HandelNatividade/DCMotorControl-By-Acceleration/Controle_Digital.pdf

SEL0359 - Controle Digital - 2°sem/2025 Prof. Marcos Rogerio Fernandes ´

## Relatorio do Projeto Final ´

Handel Emanuel Natividade Peres - N°12681368 Pedro Augusto dos Santos Kzan - N°12547465

Resumo—O objetivo desta pratica se baseia na aplica ´ | çaõ
do seu proprio controle digital, por meio da modelagem do ´
sistema e discretizaçao do modelo. Foi necess ˜ | ario definir ´
criterios de desempenho, estruturar o controlador, realizar a ´ sua sintonia e implementa-lo. Posteriormente, se mostraram ´ os resultados para os distintos setpoints e a sua rejeiçao de ˜ ruído. O tema escolhido foi o controle de um Motor DC,
por meio de um acelerometro, com h ˆ | elices desbanlanceadas ´
para garantir vibraçao suficiente no aceler ˜ | ometro. ˆ
Por meio desta vibraçao medida, buscaram-se maneiras ˜
de associa-las ao n ´ | umero de Rota ´ | çoes por Minuto do motor ˜
(RPM).
Para isso, fez-se a modelagem do sistema por PRBS, discretizou-se por meio do metodo Segurador de Ordem Zero ´ (ZOH), implementou-se um controlador tipo PI sintonizado pelo PIDTuner e o rltool¹
| | e, tambem, uma sintonia fina. ´
Por fim, dadas as limitaçoes do controle PI e a ca- ˜
racterística nao linear do modelo, um controle de n ˜ | íveis
de velocidade (baixa, media e m ´ | axima) foi realizado com ´
sucesso, apesar do elevado ruído do sistema.
I. INTRODUÇ AÕ
O sistema utilizado na pratica ´ | e composto por um ´ | air
cooler, que e usada como um motor DC girante. Junto ´ a este motor, foi acoplado um sensor acelerometro. O ˆ
objetivo desta pratica ´ | e controlar a rota ´ | çao do ˜ | air cooler
por meio da sua vibraçao, capturada pelo aceler ˜ | ometro, ˆ
presente em 1.
Para isso, mapeamos o RPM por sua vibraçao corres- ˜ pondente por meio da calibraçao e, a partir disto, com a ˜ variavel ajustada (RPM estimado) realizar controle sobre ´ a velocidade do motor a partir deste RPM estimado, que
e funç ´ | ao da vibraç ˜ | ao obtida. ˜
A captura da vibraçao de um motor ˜ | e uma maneira ´
para mensurar a vida util dele: um motor que começa a ´ vibrar de forma anormal apresenta sinais que precisa de conserto ou substituiçao, ou que seu rendimento caiu ou ˜ esta prestes a se reduzir. ´
Ademais, para produzir um maior vibraçao do motor, ˜
adicionou-se pequenas deformaçoes nas h ˜ | elices do rotor ´
para que ele vibrasse mais ao girar.

1Ferramentas presentes no software Matlab v.R2023b

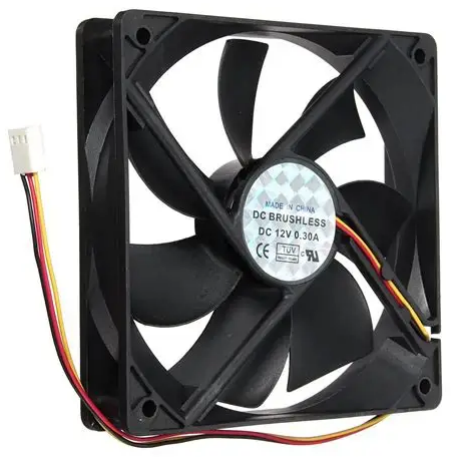
[picture p1: figure]

Figura 1: Figura ilutrativa da planta usada. Fonte: Aliexpress

A. Modelagens do Sistema
1) Modelagem de um Servomotor DC: Em geral,
o torque gerado por um motor CC e proporcional ´ | à
corrente de armadura e a intensidade do campo magn ` | etico. ´
Podemos assumir que o campo magnetico ´ | e constante e, ´
portanto, que o torque do motor e proporcional apenas ´ | à
corrente de armadura i por um fator constante Kt
, como
mostrado na equaçao abaixo. Este modelo ˜ | e conhecido ´
como motor controlado pela armadura.

T = Kt

i. (1)

A força contraeletromotriz (back emf), e, e proporcional ´
a velocidade angular do eixo por um fator constante ` | Ke.
e = Keθ˙. | (2)

Em unidades SI, as constantes de torque do motor e
da força contraeletromotriz sao iguais, isto ˜ | e,´ Kt = Ke.
Portanto, usaremos K para representar tanto a constante de torque quanto a constante de back emf.
Pode-se derivar as seguintes equaçoes governantes com ˜ base na 2ª lei de Newton e na lei das malhas de Kirchhoff. Kθ˙ representa uma voltagem gerada no motor, J o
momento de inercia do rotor, ´ | b coeficiente de atrito
viscoso.
Jθ¨ +bθ˙ = Ki. | (3)

L

di
dt
+Ri = V −Kθ˙. | (4)
FUNÇ AO DE ˜ | TRANSFERENCIA DA VELOCIDADE ˆ
ANGULAR DO MOTOR POR SUA TENSAO INDUZIDA NA ˜

ARMADURA
Aplicando a transformada de Laplace, as equaçoes de ˜ modelagem acima podem ser expressas em termos da
variavel de Laplace ´ | s.
s(Js+b)Θ(s) = K I(s). | (5)
(Ls+R)I(s) = V(s)−KsΘ(s). | (6)
Chegamos a seguinte fun ` | çao de transfer ˜ | encia em malha ˆ
aberta ao eliminar I(s) entre as duas equaçoes acima, ˜ considerando que a velocidade deve ser a saída e a tensaõ de armadura e a entrada. [3] ´

P(s) = Θ˙ (s)
V(s) = | K
s((Js+b)(Ls+R) +K²)
| | rad/s
| | V
| | ,
| | (7)
2) Modelagem do acelerometro ˆ | :
Modelagem da Funçao de Transfer ˜ | encia do Aceler ˆ | ometro ˆ
A modelagem dinamica de um aceler ˆ | ometro baseia-se ˆ
no princípio de um sistema massa–mola–amortecedor, no qual uma massa de prova e conectada ao corpo do sensor ´ por meio de uma mola de constante k e um amortecedor
de coeficiente c. A excitaçao externa ˜ | e o movimento ´
do corpo do sensor, denotado por u(t). O deslocamento relativo entre a massa de prova e o corpo e denotado por ´ x(t). [1]
A dinamica relativa entre ˆ | x(t) e u(t) e dada por: [1] ´
mx¨(t) +cx˙(t) +kx(t) = −mü(t). | (8)

Em que:
- m e a massa inercial do aceler ´ | ometro, ˆ
- c e o coeficiente de amortecimento, ´
- k e a rigidez da mola, ´
- u(t) e o movimento do corpo do sensor, ´
- x(t) e o deslocamento relativo da massa. ´ Aplicando a Transformada de Fourier e substituindo d/dt → jω, obtem-se: ´
X(ω) = | −ω
| 2

ω

2
0 −ω² + j(2ζω0ω)
U(ω), | (9)

em que ω0 =

p
k/m e a frequ ´ | encia natural e ˆ | ζ =
c/(2

√
km) e o fator de amortecimento. ´
Assim, a funçao de transfer ˜ | encia do sistema mec ˆ | anico ˆ
e:´

H(ω) = X(ω)
U(ω)
= | −ω

2

ω

| 2
0 −ω² + j(2ζω0ω)
. | (10)
Funçao de Transfer ˜ | encia no Caso de Baixas Frequ ˆ | encias ˆ
Para acelerometros MEMS, a frequ ˆ | encia natural ˆ | é
tipicamente muito elevada (ω0 ≫ faixa de operaçao), ˜ de modo que ω ≪ ω0. E mostrado por Hons e Stewart ´ (2006) que, nesse regime, a equaçao se simplifica para: ˜

H(ω) ≃

X(ω)
U(ω)

≃

1

ω

2
0
. | (11)

E como o transdutor converte diretamente o desloca-
mento relativo x(t) em tensao, a sa ˜ | ída e proporcional ´ | à
aceleraçao do corpo: ˜

x(t) ≈ −

1

ω

2
0
| | ü(t). | (12)

Assim, o acelerometro atua como um sensor de ˆ
aceleraçao com resposta plana na banda de operaç ˜ | | | ao. ˜
Expressao Normalizada da Funç ˜ | | ao de Transfer ˜ | encia ˆ

A forma mais utilizada em engenharia de controle para
documentar o acelerometro ˆ | e:´

H(s) = X(s)
U(s)
| = | s

2

s

2 +2ζω0s+ω

| | | 2
| | | 0
. | (13)
Esta funçao de transfer ˜ | encia descreve completamente ˆ
a dinamica mec ˆ | anica do aceler ˆ | ometro, representando um ˆ
sistema de segunda ordem típico de sensores MEMS.
3) Modelagem da Vibraçao da Ventoinha ˜ | : A ventoi-
nha utilizada no experimento funciona como um motor DC, produzindo vibraçao mec ˜ anica devido ao desbalance- ˆ amento do rotor. Essa vibraçao pode ser aproximada por ˜
um sinal harmonico, cuja frequ ˆ | encia depende diretamente ˆ
da velocidade angular do motor.
A aceleraçao medida pelo aceler ˜ | ometro pode ser ˆ
descrita por:
a(t) = Asin(ωt). | (14)

onde:
- A e a amplitude da vibraç ´ | ao; ˜
- ω e a velocidade angular do motor em rad/s. ´
A amplitude da vibraçao cresce proporcionalmente ˜ | à
velocidade angular:
| A ∝ ω; | | (15)

Portanto, o acelerometro pode ser utilizado como um ˆ estimador indireto da velocidade do motor, especialmente
atraves do c ´ | alculo do valor RMS da aceleraç ´ | ao medida. ˜
4) Relaçao entre Acelera ˜ | çao, Vibra ˜ | çao da Ventoinha ˜
e Potencia Mec ˆ | anica ˆ | : Com a modelagem do motor DC,
da vibraçao induzida pelo desbalanceamento do rotor ˜
e da dinamica do aceler ˆ | ometro, ˆ | e poss ´ | ível estabelecer
uma funçao de transfer ˜ | encia completa entre a pot ˆ | encia ˆ

mecanica produzida pelo motor e a acelera ˆ | | çao medida ˜
pelo sensor.
A vibraçao da ventoinha foi modelada como um ˜ sinal harmonico cuja amplitude depende diretamente da ˆ velocidade angular:
a(t) = Asin(ωt), | A ∝ ω. | (16)

Linearizando em torno de um ponto de operaçaõ ω0,
obtem-se a relaç ´ | ao de pequenos sinais: ˜
∆a(t) = Ka ∆ω(t), | (17)

onde Ka e um ganho determinado experimentalmente e ´ depende do nível de desbalanceamento da ventoinha.
Por outro lado, a potencia mec ˆ | anica do motor ˆ | e dada ´
por:
P(t) = T(t)ω(t) = Kt
| | i(t)ω(t). | (18)
Para pequenas variaçoes em torno do ponto ˜ | (i0,ω0), a
potencia pode ser linearizada: ˆ
∆P(t) ≃ Kt (i0 ∆ω(t) +ω0 ∆i(t)). | (19)

Assumindo que a corrente e regulada rapidamente ou ´
que suas variaçoes s ˜ | ao pequenas, ˜
| ∆P(t) ≈ Kt | i0 ∆ω(t). | (20)
Substituindo (17) em (20), obtem-se a rela ´ | çao est ˜ | atica ´
entre potencia e aceleraç ˆ | ao: ˜
| ∆P(t) = Kt

i0
Ka
| | ∆a(t). | (21)
a) Inclusao da Din ˜ | amica do Aceler ˆ | ometro: ˆ | A
dinamica do aceler ˆ | ometro foi previamente modelada como ˆ
um sistema massa–mola–amortecedor:
H(s) = X(s)
| U(s) = | s
| | 2

s

| | 2 +2ζω0s+ω
| | 2
| | 0
| | . | (22)
No regime de baixas frequencias (faixa de opera ˆ | çaõ
do experimento),
| x(t) ≈ −

1

ω

2
0
| | ü(t), | (23)
de modo que a saída do acelerometro ˆ | e diretamente ´
proporcional a aceleraç ` | ao verdadeira do corpo. ˜
Portanto, no domínio de Laplace, a aceleraçao medida ˜ e:´
A(s) = Hacc(s)U(s), | (24)

onde, no regime operacional,

Hacc(s) ≃ 1. | (25)
b) Funçao de Transfer ˜ | encia Final: Pot ˆ | encia a partir ˆ
da Aceleraçao: ˜ | Combinando (21) com a dinamica do ˆ
acelerometro, a fun ˆ | çao de transfer ˜ | encia entre a acelera ˆ | çaõ
medida e a potencia mec ˆ | anica ˆ | e:´

GP←A(s) = ∆P(s)
∆A(s)

=

Kt

i0
Ka

·

1

Hacc(s)

. | (26)
No regime de baixas frequencias — v ˆ | alido para ´
ventiladores de pequeno porte — tem-se Hacc(s) ≃ 1, e portanto:

GP←A(s) ≃

∆P(s)
∆A(s)

=

Kt

i0
Ka

(27)

Esta expressao mostra que a pot ˜ | encia mec ˆ | anica pode ˆ
ser estimada diretamente a partir da aceleraçao RMS ˜ medida pelo acelerometro, com um ganho proporcional ˆ que depende apenas das características do motor e sua corrente e do desbalanceamento das helices acopladas no ´ motor.
B. Controle no Sistema: PI

Para o controle neste trabalho, utilizamos controle PI.
O controle PI segue a formula ´ | 28:

u(t) = Kp e(t) +Ki

Z t

0

| e(τ)dτ | (28)

Deste modelo, temos que a parcela Kp, parcela proporcional, causa um efeito mais direto e agressivo no controle. Ela reduz o erro de forma proporcional a quanto erro ha no sistema. Aumentar esta parcela causa ´
resposta mais rapida e agressiva, mas um ´ | Kp alto demais
pode causar oscilaçoes e overshoot no sistema. Um valor ˜ baixo demais para Kp resulta em resposta mais distante do setpoint e mais lenta, muitas vezes com controle distante do setpoint ou fraco, insuficiente.
Ja a parcela ´ | Ki

, termo integrativo, soma o erro que já existe no sistema para realizar açao corretiva ao erro, ˜ eliminando o erro de regime permanente. Aumentar
esta parcela causa aproximaçao mais r ˜ | apida da sa ´ | ída
ao setpoint, porem com um valor alto demais, o ´ | | Ki
pode acumular para o erro valores maiores do que o verdadeiro, causando oscilaçoes em torno do setpoint, ou ˜ resposta errada frente a disturbios. Com um valor baixo ´ demais para Ki

, o sistema apresentara erro permanente ´ nao removido. ˜
Na sintonia do controlador PI, e necess ´ | ario escolher ´
valores otimos e balanceados para ´ | Kp e Ki de modo que se
obtenha as respostas mais proximas do setpoint e est ´ | aveis. ´
Muitas vezes tambem se usa controle PID que inclui ´
a parcela Kd, mas esta parcela e sens ´ | ível e no caso desta
pratica, iria prejudicar o controle, porque este sistema ´ | | é
cheio de ruídos.
E ideal utilizar as parcelas ´ | Kp e Ki em sintonia robusta
em um sistema com ruídos como este.

C. Outras tecnicas implementadas neste sistema de ´ Controle Digital
1) Filtro EMA: Com o objetivo de atenuar os efeitos de ruídos presentes nos sinais medidos do sistema, encontramos e aplicamos no sistema a tecnica de filtro de ´
Media M ´ | ovel Exponencial (Exponential Moving Average ´
– EMA). Esta tecnica ´ | e muito rent ´ | avel devido ´ | a sua sim- `
plicidade de implementaçao e baixo custo computacional, ˜ sendo especialmente adequada para aplicaçoes em tempo ˜ real.
O filtro EMA realiza uma ponderaçao exponencial ˜ entre o valor atual do sinal e o valor previamente filtrado, conforme a Equaçaõ 29.
y[k] = α x[k] + (1−α) y[k −1]. | (29)

Em que x[k] representa o sinal de entrada no instante
discreto k, y[k] e o sinal filtrado, e ´ | | α ∈ (0,1) e o fator de ´
suavizaçao, respons ˜ | avel pelo compromisso entre resposta ´
rapida e rejeiç ´ | ao de ru ˜ | ído.
Quanto maior o coeficiente α, mais ruído o filtro deixa passar, e quanto menor, mais filtrado fica o sinal.
Neste trabalho, obtivemos resultados satisfatorios fi- ´ xando o α em α=0,03.
2) Anti-windup: Em sistemas de controle com atuaçaõ
limitada, a saturaçao do atuador pode levar ao ac ˜ | umulo ´
excessivo da açao integral, fen ˜ | omeno conhecido como ˆ
integrator windup. Este efeito pode degradar o desempenho do sistema, aumentando o sobressinal e o tempo de acomodaçao, al ˜ em de comprometer a estabilidade. ´
Com o objetivo de mitigar este problema, utiliza-
se a tecnica de ´ | anti-windup, que consiste em limitar
ou realimentar a açao integral sempre que o sinal de ˜ controle atinge os limites físicos do atuador. Uma das
abordagens mais empregadas e o m ´ | etodo de realimenta ´ | çaõ
por retrocalculo ( ´ | back-calculation), descrito pela Equaçaõ
30.
x˙i(t) = e(t) +Kaw (usat(t)−u(t)). | (30)
Em que xi(t) representa o estado da açao integral, ˜ | e(t)
e o erro do sistema, ´ | u(t) e o sinal de controle antes da ´
saturaçao, ˜ | usat(t) e o sinal de controle saturado, e ´ | Kaw
e o ganho de anti-windup. Neste trabalho, utilizamos ´ Kaw = 0.2.
Alem disso, em sistemas sujeitos a elevados n ´ | íveis
de ruído, como o desta pratica, varia ´ | çoes r ˜ | apidas no ´
erro podem induzir oscilaçoes na a ˜ | çao integral, levando o ˜
controlador a atingir repetidamente a saturaçao do atuador. ˜
Nesses casos, a combinaçao do mecanismo de ˜ | anti-windup
com tecnicas de filtragem do sinal de erro, como o filtro ´
de Media M ´ | ovel Exponencial (EMA), contribui para uma ´
atuaçao mais est ˜ | avel e robusta do controlador. ´
Desta forma, o anti-windup nao apenas previne o ˜
acumulo excessivo da a ´ | çao integral, mas tamb ˜ | em reduz os ´

efeitos adversos do ruído sobre o desempenho dinamico ˆ do sistema.

II. MATERIAIS E METODOS ´

A. Materiais

Tabela I: Lista de Materiais e Componentes Utilizados

Componente / Item | Tipo | Quantidade
MATLAB | software | 1
Arduino IDE | software | 1
Protoboard | | 1
1N4148 | Diodo | 1
1k, 1k2, 2x10, 560 [Ω] | Resistores | 5
Motor DC | | 1
Fonte DC | 12V | 1
Arduino Nano | Microcontrolador | 1
ADXL345 | Acelerometro | 1 ˆ
PC817C | Optoacoplador | 1
BC 337 | Transistor NPN | 1
BC 327 | Transistor PNP | 1
IRFZ44N | MOSFET | 1
B. Metodos ´
A metodologia e os passos do projeto aqui apresentados
sao sumarizados por meio da figura ˜ | | 2 em que as seguintes
tarefas sao feitas: ˜
1) Montagem do circuito:
2) Verificaçao da resposta do motor para diferentes ˜ tensoes; ˜
3) Obteve-se a Transformada de Fourier Rapida (FFT) ´
do sistema usando o Sinal Binario Pseudo-aleat ´ | orio ´
| (PRBS);
4) Obtençao do Gr ˜ | afico de Bode; ´
5) Implementaçao do Filtro Digital ˜
6) Ajuste da quantidade de Polos e zeros da Funçao de ˜
| Transferencia estimada; ˆ
7) Ajuste dos Ganhos do Controlador PID
8) Validaçao em diferentes Setpoints ˜
Montou-se o circuito conforme a imagem 4 e como
ha uma tens ´ | ao de 12V de alimenta ˜ | çao ao motor DC, ˜
implementou-se um optoacoplador para isolamento do arduino nano, seu resultado final pode ser visto na imagem 3.
A comunicaçao do aceler ˜ | ometro com o microcontrola- ˆ
dor foi feita via SPI com o range de 16G para evitar a sua saturaçao com taxa interna de amostragem configurada ˜ para 200 Hz [2], os dados obtidos sao referentes ao ˜ 3 eixos, logo, a soma dos seus quadrados garante que vejamos a potencia do sinal em sua completude. ˆ

2
2E importante salientar que o arduino est ´ | a funcionando em uma taxa ´
de 100 Hz, a comunicaçao serial em 115200 simbolos/s. ˜

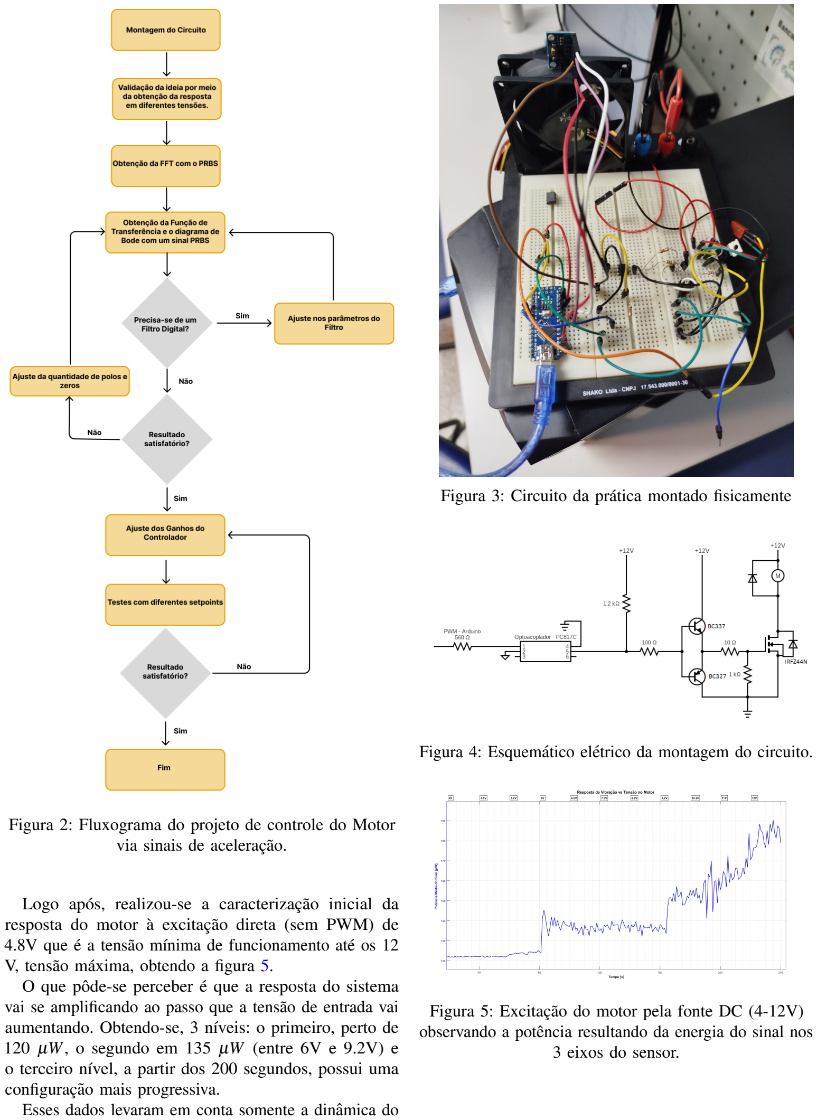
[picture p2: page 5]

Figura 2: Fluxograma do projeto de controle do Motor via sinais de aceleraçao. ˜

Logo apos, realizou-se a caracteriza ´ | çao inicial da ˜
resposta do motor a excita ` | çao direta (sem PWM) de ˜
4.8V que e a tens ´ | ao m ˜ | ínima de funcionamento ate os 12 ´
V, tensao m ˜ | axima, obtendo a figura ´ | 5.
O que pode-se perceber ˆ | e que a resposta do sistema ´
vai se amplificando ao passo que a tensao de entrada vai ˜ aumentando. Obtendo-se, 3 níveis: o primeiro, perto de 120 µW, o segundo em 135 µW (entre 6V e 9.2V) e o terceiro nível, a partir dos 200 segundos, possui uma configuraçao mais progressiva. ˜
Esses dados levaram em conta somente a dinamica do ˆ

Figura 3: Circuito da pratica montado fisicamente ´

Figura 4: Esquematico el ´ etrico da montagem do circuito. ´

Figura 5: Excitaçao do motor pela fonte DC (4-12V) ˜ observando a potencia resultando da energia do sinal nos ˆ 3 eixos do sensor.

sistema sem nenhuma calibraçao, o que explica o offset. ˜
Criou-se entao a fun ˜ | çao de calibra ˜ | çao que por um tempo ˜
especificado pelo usuario mede o offset em cada um dos ´
eixos de mediçao do aceler ˜ | ometro. ˆ
Outras funçoes do c ˜ | odigo permitem o controle do motor ´
via PWM, o monitoramento via grafico no matlab ou ´ monitor serial, ajuste dos ganhos, da deadzone e uma resposta adaptativa de calibraçao ao decorrer do tempo. ˜ Em seguida, com o pwm variavel fez-se dois procedi- ´ mentos, o primeiro foi tabelar a velocidade do sistema para poder correlacionar com a potencia do sinal do ˆ
acelerometro, observado em ˆ | | 7 e, tambem, um outro teste ´
foi feito buscando correlacionar a tensao no gate do ˜ mosfet com o PWM e as Rotaçoes por Minuto, visto em ˜ 6.
Com base nessas relaçoes, as equa ˜ | çoes para a estima- ˜
tiva da velocidade do motor com base na vibraçao da ˜ plataforma, foram feitas e inseridas no codigo arduino. ´

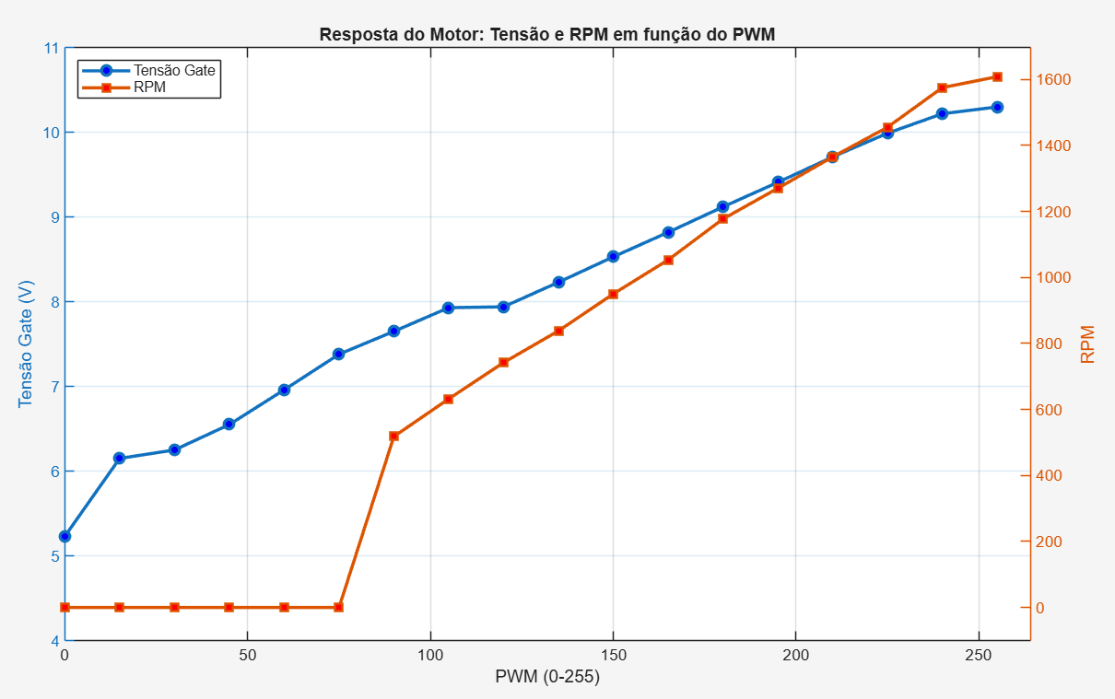
[picture p3: figure]

Figura 6: Grafico de estudo inicial verificando a ´
influencia da variaç ˆ | ao do sinal de entrada nas Rotaç ˜ | oes ˜
e na tensao do Gate do Mosfet, respons ˜ | avel por acionar ´
o motor.

Com a ideia tendo sido minimamente validada e posse
das equaçoes que convertem os dados do aceler ˜ | ometro em ˆ
estimativas do RPM do motor³
| | . Fez-se a caracterizaçaõ
via PRBS por meio do codigo disponibilizado e obteve-se ´
a figura 8, os dados tambem est ´ | ao disponibilizados no ˜
Github do projeto⁴ | , serao os direcionadores acerca da ˜
característica do sistema e a melhor maneira de controla-´ lo.
Usando a ferramenta ident do matlab obteve-se uma
funçao de transfer ˜ | encia do sistema sem nenhum uso de ˆ
filtro, descrita em 10 e a Tranformada Rapida de Fourier ´ do sinal, em 9 para observar o seu compormento nas diferentes frequencias. ˆ
Depois disso, fez-se o diagrama de bode e procurou-se criar um filtro que eliminasse as altas frequencias. ˆ

3Todo este projeto foi feito com 10ms como período de amostragem. 4Disponível em: https://github.com/HandelNatividade/DCMotorControl-By-Acceleration

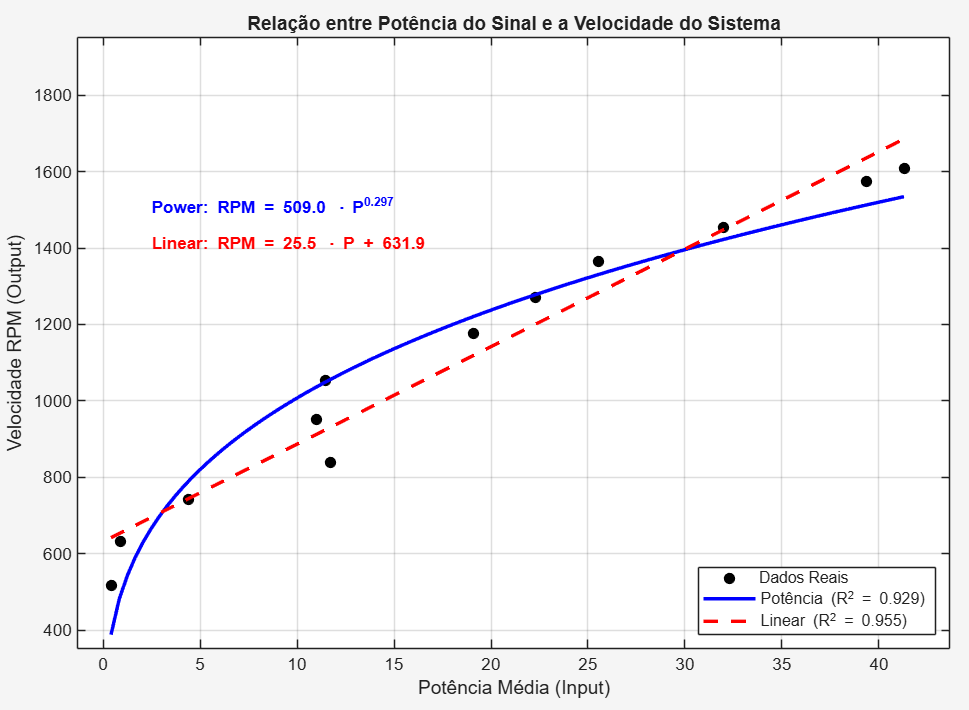
[picture p4: figure]

Figura 7: Curvas que buscam traduzir a relaçao entre a ˜
potencia do sinal de vibraç ˆ | ao e a rotaç ˜ | ao do motor. ˜

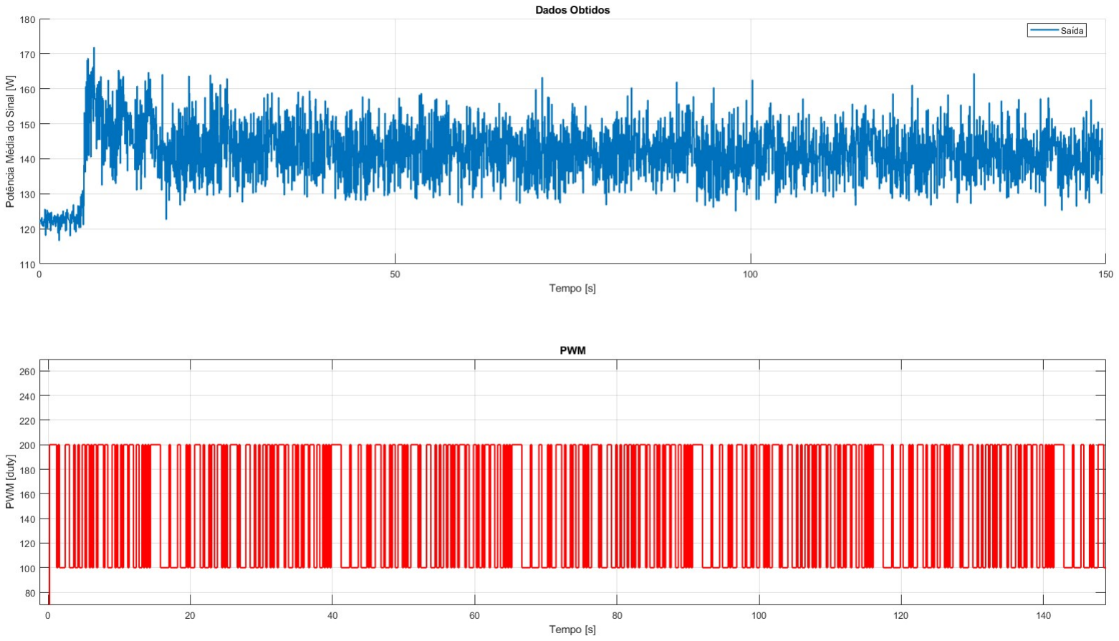
[picture p5: figure]

Figura 8: Resposta da Potencia M ˆ | edia do Sinal do ´
Acelerometro nos 3 eixos ao sinal PWM aplicado. ˆ

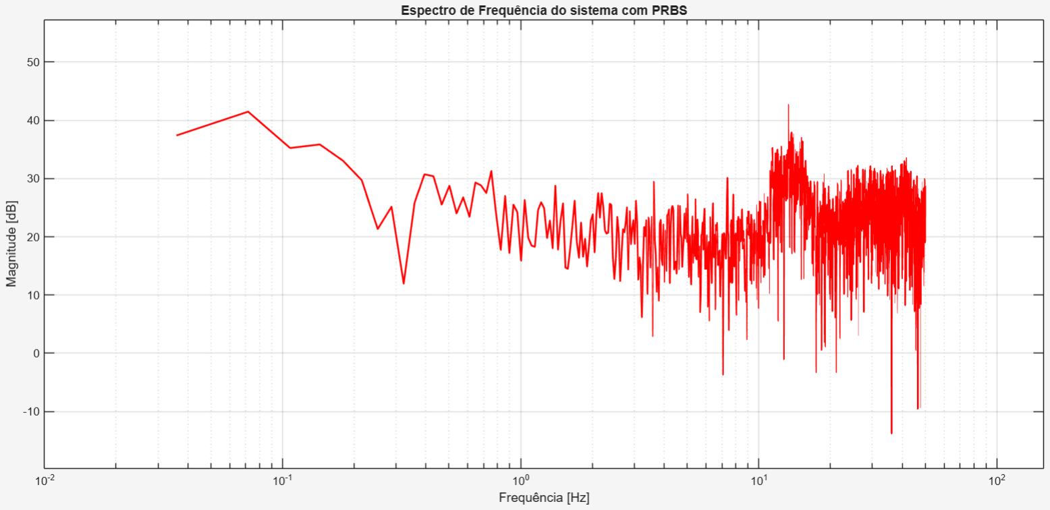
[picture p6: figure]

Figura 9: FFT do sistema sem filtragem com o PRBS de entrada.

Logo apos, uma nova caracteriza ´ | çao via PRBS foi feita ˜
e uma nova Funçao de Transfer ˜ | encia obtida. Os ganhos ˆ
do controlador foram sendo ajustados e a resposta do sistema para diferentes setpoints e quando ha uma parada ´ brusca no motor foram, por fim, documentados.

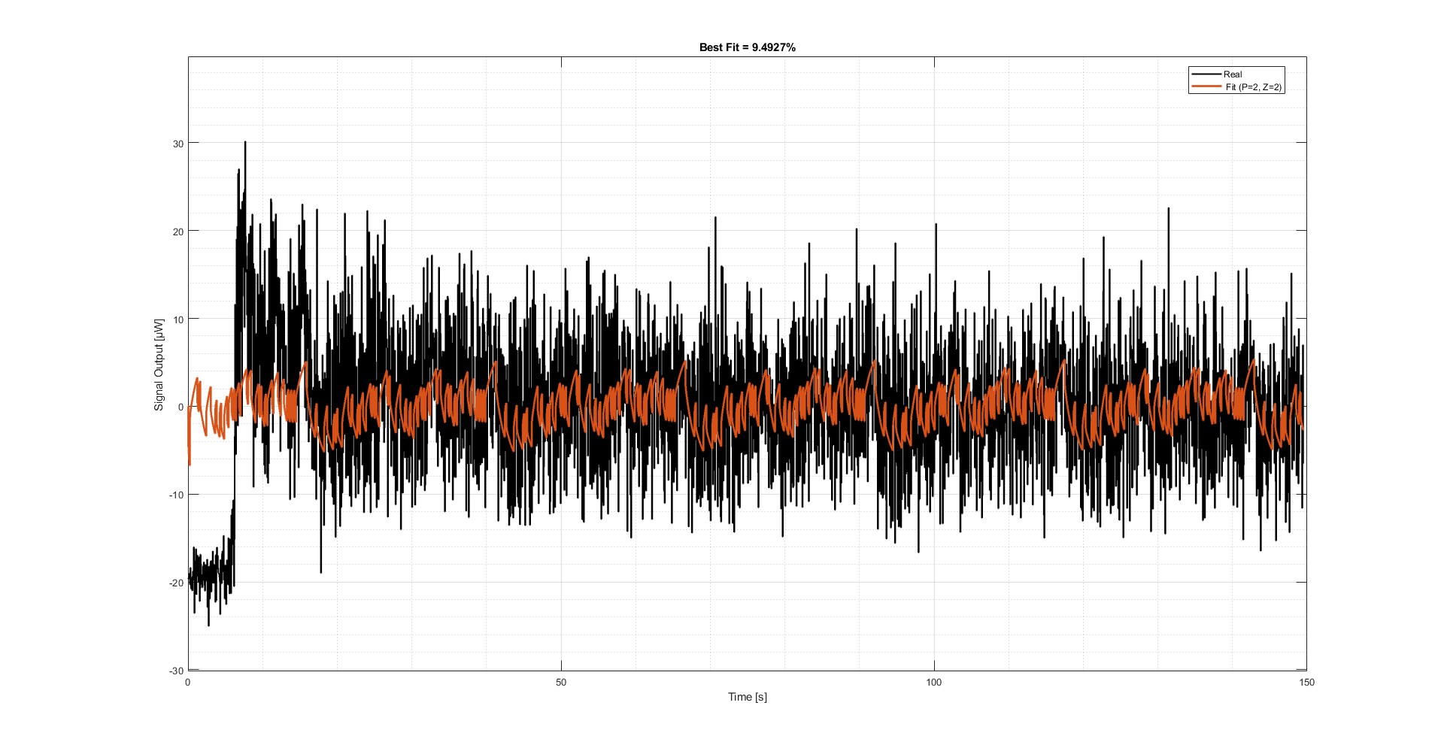
[picture p7: figure]

Figura 10: Funçao de Transfer ˜ | encia com 2 polos e 2 ˆ
zeros do sistema sem filtro e com valor de ajuste menor
| que 10%.

III. RESULTADOS EXPERIMENTAIS E DISCUSSOES ˜

A. Estimaçao da funç ˜ | ao transfer ˜ | encia ˆ
O valor de ajuste obtido na primeiro modelo de funçaõ
de transferencia ressalta que a din ˆ | amica apontava para ˆ
algo com 2 polos e 2 zeros, mas um resultado de ajuste
de 9.492%⁵ praticamente nao permite fazer infer ˜ | encia ˆ
alguma acerca do sistema.
Como o índice de ajuste foi demasiado pequeno, um filtro EMA foi adicionado no sistema de controle, entregando a ele um sinal, filtrado, com muito menos ruído, o que permitiu melhor observabilidade do sinal
medio, polido dos seus ru ´ | ídos.
Por conseguinte, obteve-se controle mais estavel e ´ capacidade para estimar de forma minimamente precisa as
possíveis funçoes transfer ˜ | encia do sistema. O par ˆ | ametro ˆ
α do filtro foi ajustado para α = 0,03, que obtivemos mais sucesso e resultados mais satisfatorios. ´
Alem disso, por testes pr ´ | evios, se ajustou os ganhos ´
Kp e Ki para Kp = 9 e Ki = 0.9, valores que entregaram
resposta mais rapida e mantiveram precis ´ | ao nos resultados ˜
e esforço de controle.
Assim, realizou-se um ensaio PRBS, capturando os sinais de RPM estimado bruto e filtrado, como indicado na figura 11. Em seguida, utilizando o tfest, obtivemos
estimaçoes para os modelos de fun ˜ | çao transfer ˜ | encia do ˆ
sistema pelos sinais PRBS.
A nova funçao de transfer ˜ | encia, ilustrada em ˆ | 12, tem no
domínio de Laplace a representaçao descrita pela equa ˜ | çaõ
(31) e sua representaçao discretizada em ( ˜ | 32).
G(s) = | 66.87s−10.09
s

2 +0.2658s+0.08221

(31)

G(z) = 6.621z−6.649
z

2 −1.997z+0.9973

(32)

O modelo de melhor ajuste e menor complexidade foi escolhido nessa segunda aquisiçao via PRBS. Tendo 2 ˜

5Os outros valores sao descritos no ap ˜ | endice A. ˆ

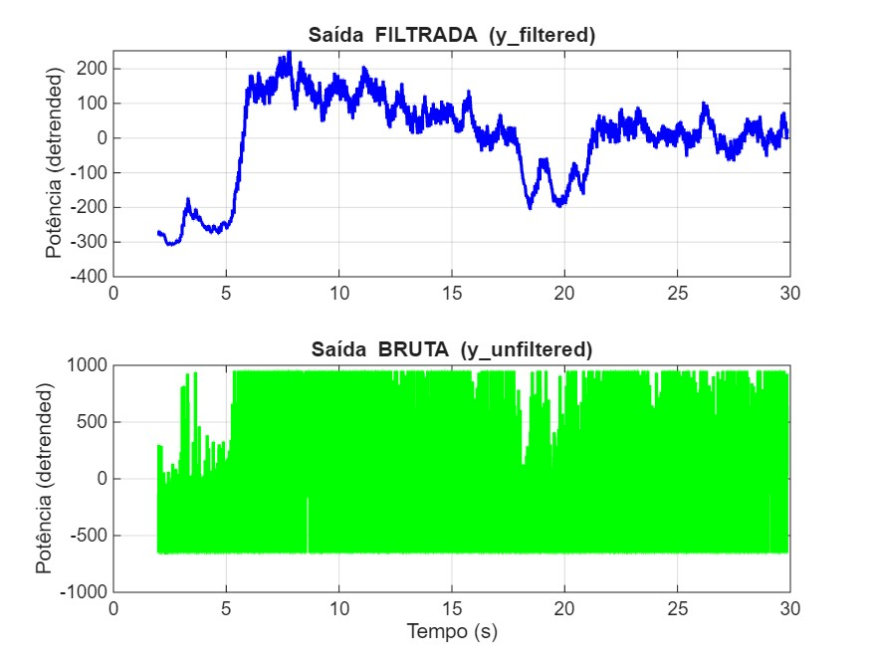
[picture p8: figure]

Figura 11: PRBS: comparaçao entre sinal filtrado e ˜ bruto do RPM estimado a partir da vibraçao. ˜

polos e 1 zero e ajuste 54,91%, um resultado extrema-
mente satisfatorio para um sistema t ´ | ao ruidoso quanto o ˜
desta pratica, descrito em ( ´ | 32).

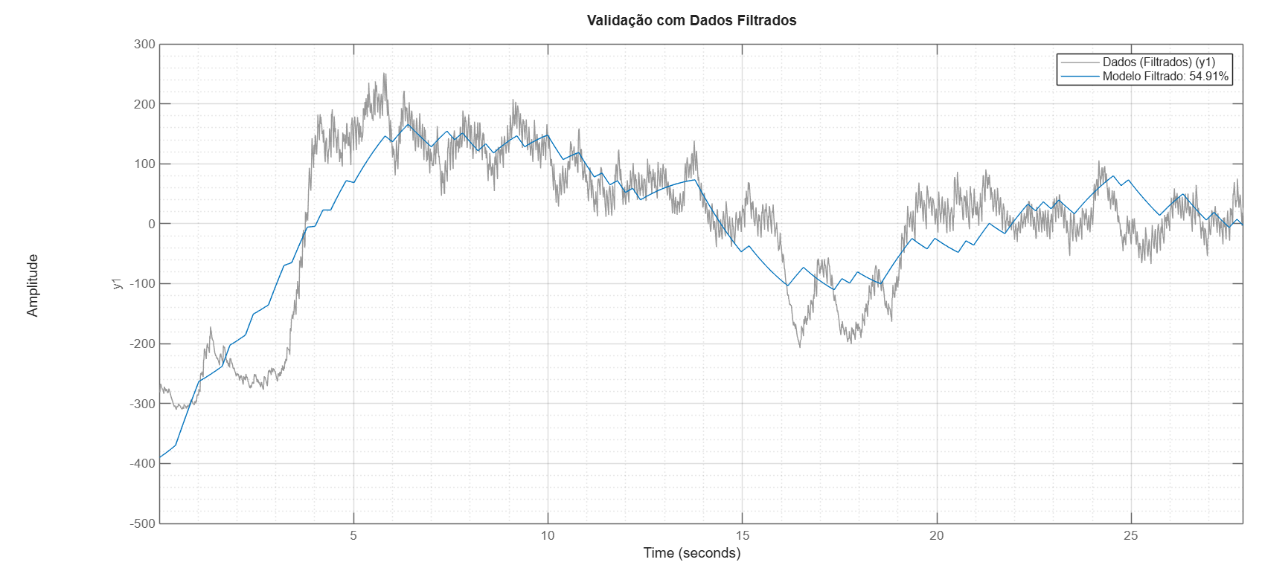
[picture p9: figure]

Figura 12: Nova funçao de Transfer ˜ | encia com o modelo ˆ
filtrado e ajuste de 54.91%.
O filtro adicionado e ajustado foi util para a obten ´ | çaõ
de modelos de melhor estimaçao, a hip ˜ | otese era que um ´
filtro para as altas frequencias era o necess ˆ | ario ´

6
Os resultados, apresentados na figura 13 em que ha o ´ diagrama de bode da funçao estimada, ao passo que na ˜ figura 14 esta o diagrama de bode para os dados reais ´
comprovou a eficiencia do filtro para frequ ˆ | encias acima ˆ
de 1 rad/s.
Observa-se que a resposta da versao filtrada do RPM ˜ estimado e mais fidedigna ao comportamento esperado de ´ um sistema físico, apresentando variaçao de fase coerente ˜ no diagrama de Bode.
Em contrapartida, o sinal bruto de RPM nao apresenta ˜
alteraçao significativa de fase, indicando forte influ ˜ | encia ˆ
de ruído e ausencia de uma din ˆ | amica representativa do ˆ
sistema.

6A premissa era que valorizar as frequencia mais baixas facilitaria ˆ
no controle, mas apos a an ´ | alise da documenta ´ | çao completa v ˜ | e-se que ˆ
ha informa ´ | çoes relevantes entre 1 Hz e 27 Hz que s ˜ | ao relacionadas ao ˜
giro do motor. Fato evidente na FFT e no diagrama de bode.

Ademais, o sinal bruto apresenta maior magnitude geral e claros indícios de forte presença de ruídos de alta frequencia, acima de 40 Hz. ˆ

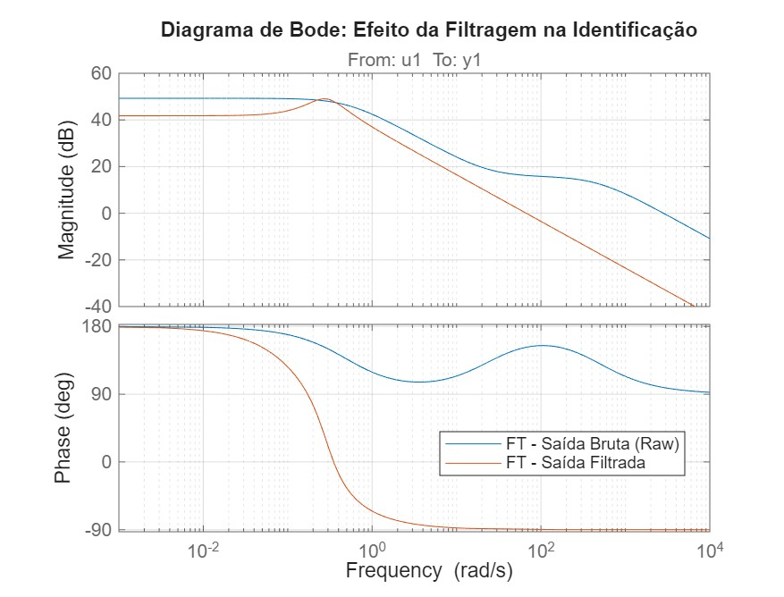
[picture p10: figure]

Figura 13: Diagrama de bode de magnitude e fase: sistemas estimados.

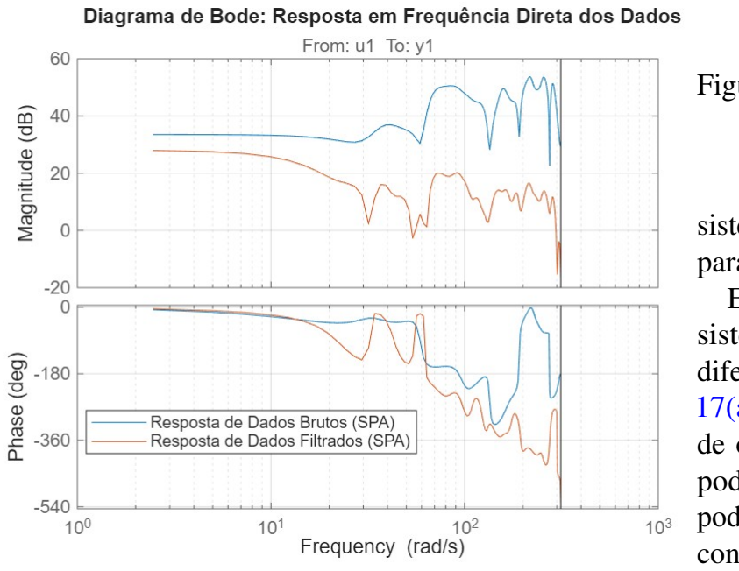
[picture p11: figure]

Figura 14: Diagrama de Bode magnitude e fase: sinais reais, bruto e filtrado.

Ademais, nas figuras 15 e 16, pode se observar respectivamente a FFT da entrada PRBS, e como o sistema se comportou, em uma versao filtrada dos dados ˜ com α = 0,03, e na versao dos dados brutos. Assim, ˜ pode se notar o comportamento do sistema, que apresenta
ruídos de alta frequencia na vers ˆ | ao bruta dos dados. ˜
B. Resposta a setpoints do sistema e rejeiçao de ˜ disturbios ´
Apos a modelagem e ajustou-se de ´ | Kp e Ki em 9 e
0.9, respectivamente, buscando uma resposta rapida no ´

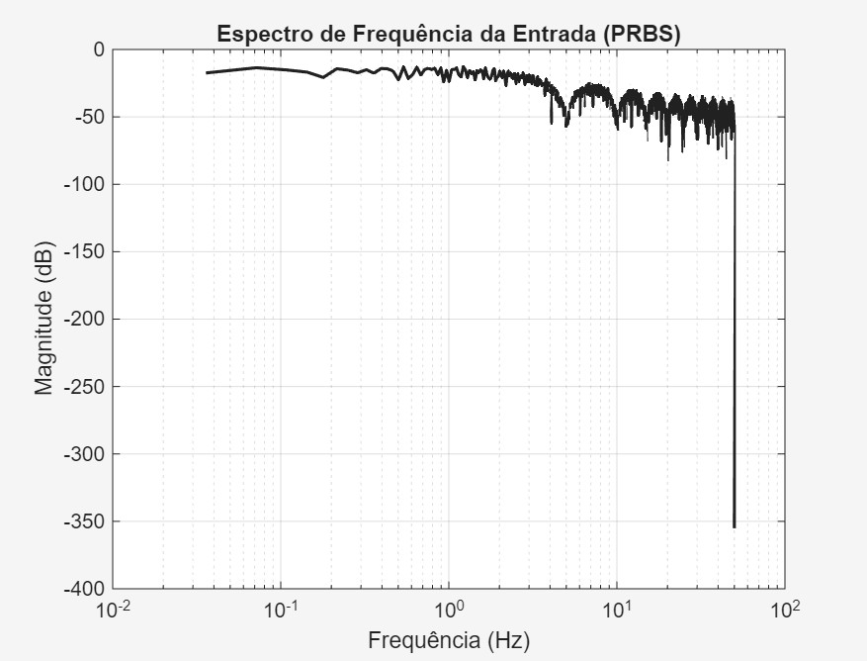
[picture p12: figure]

Figura 15: FFT do sinal de entrada no PRBS.

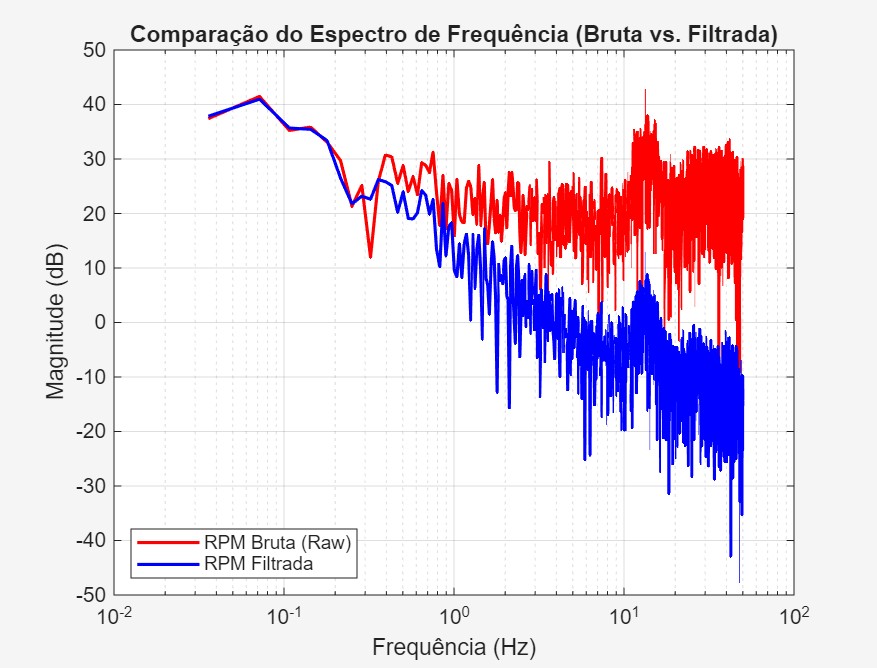
[picture p13: figure]

Figura 16: Comparaçao da FFT entre o sinal filtrado e o ˜ bruto da saída.

sistema e que nao apresentasse imprecis ˜ | oes. Estes valores ˜
para os coeficientes bastaram.
Em seguida, testou-se o efeito do ajuste do filtro no sistema, obtendo-se respostas do sistema filtrado para diferentes setpoints, que foram documentadas nas figuras 17(a) e 17(b) com um resultado melhor na amplitude
de oscilaçao no teste da figura ˜ | 17(b). Nesta comparaçao, ˜
pode-se observar o começo do efeito do filtro. A saída
pode ser ruidosa, mas a versao filtrada, que o esfor ˜ | ço de
controle le, faz o esfor ˆ | ço de controle ser menos instavel, ´
o que tambem preserva a vida ´ | util do sistema de cargas. ´
A variaçao em setpoint visou testar para baixa veloci- ˜ dade, em que o motor começa a girar, media velocidade, ´ e velocidade maxima. As velocidades de setpoint foram ´ 850RPM, 1200RPM e 1650RPM.
Assim, ajustando-se o parametro do filtro ˆ | α para o
valor final de 0,03, nota-se que o esforço de controle ficou
muito mais preciso e constante, estavel, o que ´ | e ideal ´
neste sistema em que o PWM apresenta proporcionalidade ao RPM.
18.
Ademais, testou-se a rejeiçao a dist ˜ | urbios do sistema, ´
introduzindo perturbaçao na rota ˜ | çao. Apenas destaca-se ˜
que este teste foi realizado apos diversos testes do motor, ´

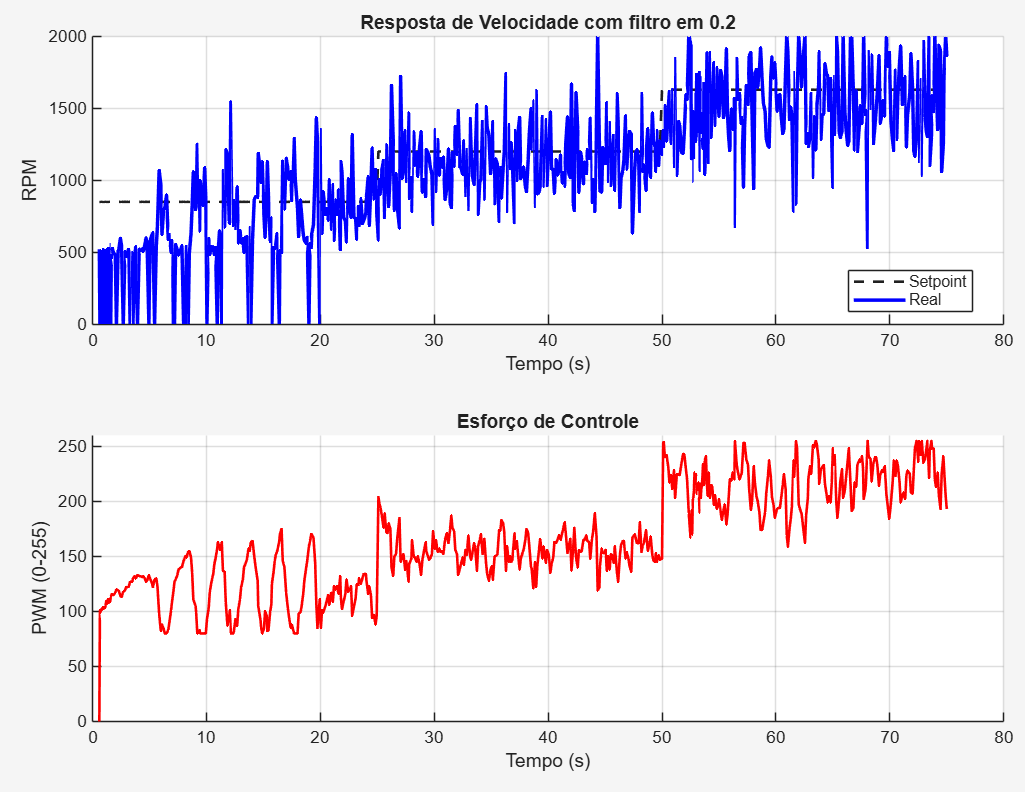
[picture p14: figure]

(a) Resposta do sistema com
parametro do filtro EMA ( ˆ | α) em
0,2.

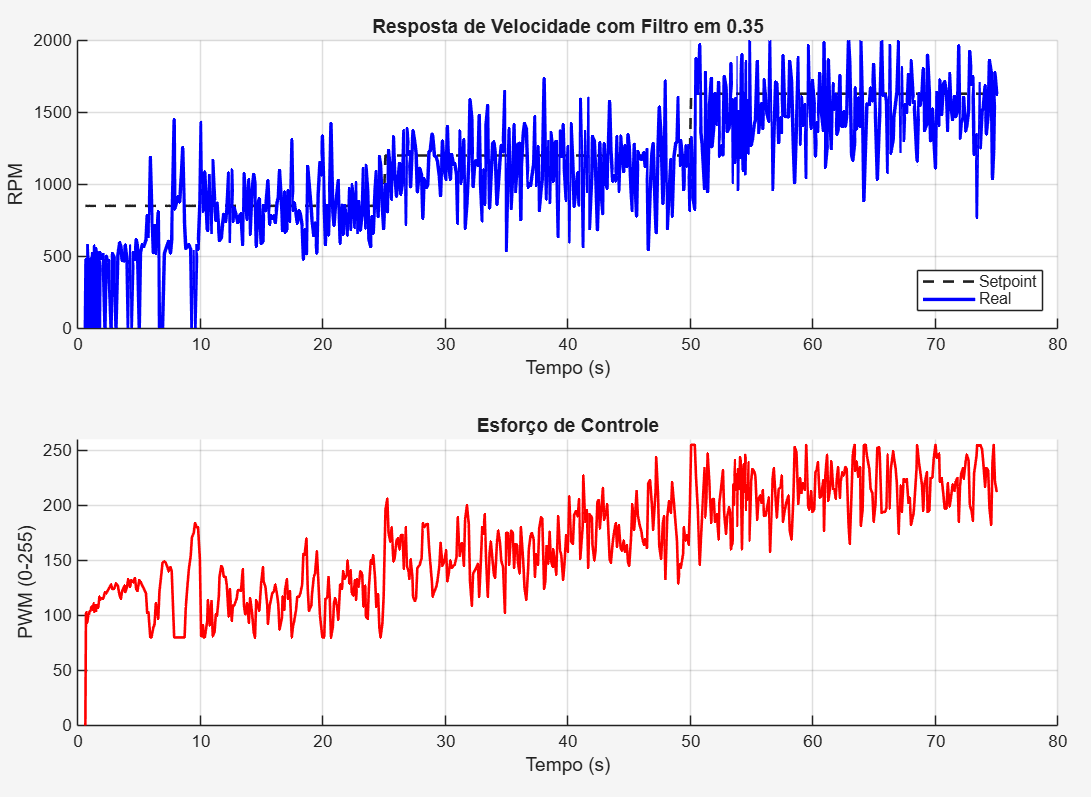
[picture p15: figure]

(b) Resposta do sistema com
parametro do filtro EMA ( ˆ | α)em
0,35.

Figura 17: Comparativo do eficiencia do filtro no ˆ processo de obtençao dos setpoints de 850, 1200 e 1650 ˜ RPM.

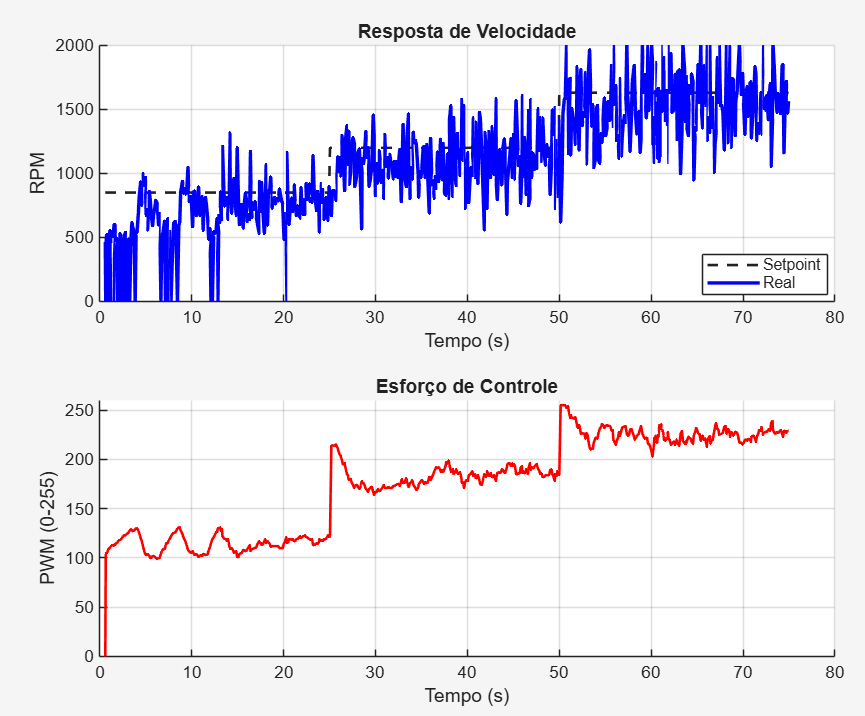
[picture p16: figure]

Figura 18: Resposta do sinal com sintonia do controlador (ki = 0.9, kp = 9, Kaw = 0.2) e filtragem do sinal (α = 0.03).

e o motor perturbado (vibrando mais) possivelmente se desgastou, atingindo menos RPM para mais controle. No
entanto, a obtençao da resposta em ˜ | 19 nao foi prejudicada, ˜
pois verificou-se a capacidade de se manter no setpoint e
recuperar a rotaçao de antes do dist ˜ | urbio ´
Assim, na rejeiçao a dist ˜ | urbio nota-se que o sistema ´
responde rapidamente buscando aumentar a velocidade
frente a disturbios, nota-se que a escolha de fortes ´ | Kp e
Ki contribuiu para resposta rapida, o sistema apresenta ´
boa rejeiçao a dist ˜ | urbio, dado que o esfor ´ | ço de controle
le uma vers ˆ | ao filtrada e m ˜ | edia dos dados da sa ´ | ída: RPM
estimado.
| | IV. CONCLUSAÕ

O projeto de controle de um motor simples motor DC com base na vibraçao, mostrou-se promissor a partir ˜ dos resultados aqui descritos. Obviamente, ha diversos ´
aspectos que sao pass ˜ | íveis de melhoria como a modelagem

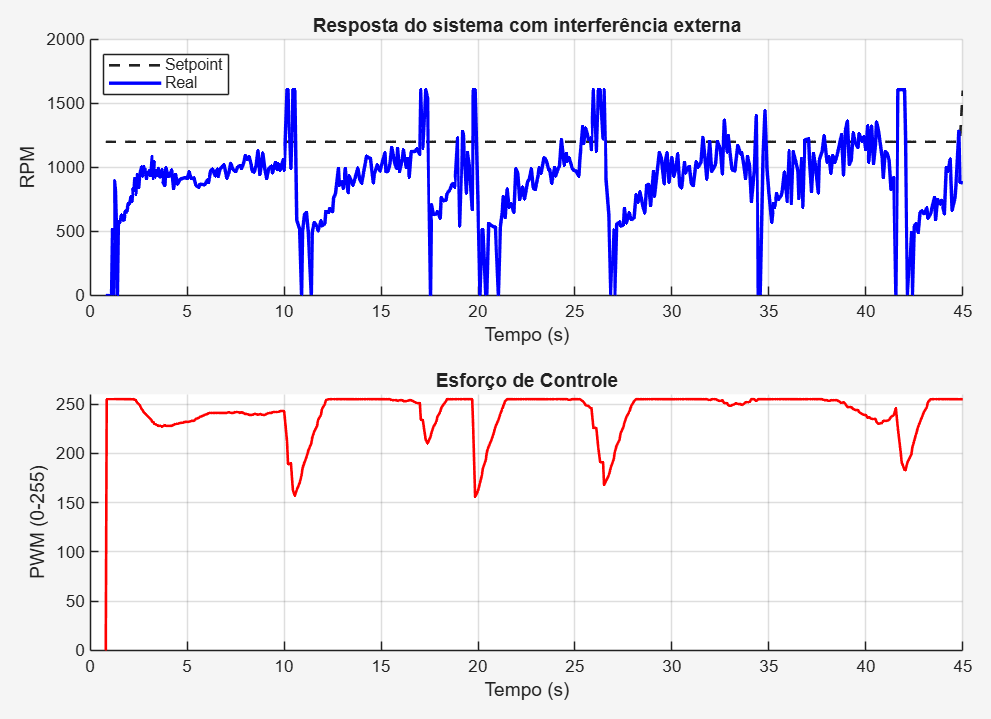
[picture p17: figure]

Figura 19: Resposta do sistema a pertuba ` | çoes em 10, 17, ˜
20, 27, 34 e 43 segundos.
da propagaçao do ru ˜ | ído pela estrutura da planta e uma
caracterizaçao mais fidedigna dos ru ˜ | ídos da estrutura
relevantes para a prediçao da rotaç ˜ | ao. ˜
A simulaçao da propaga ˜ | çao da vibra ˜ | çao pela estrutura ˜
do material por meio de softwares baseados em Metodos ´ de Elementos Finitos poderia responder se um outro
acelerometro deve ser colocado e uma fus ˆ | ao de dados ser ˜
feitas ou realocaçao do aceler ˜ | ometro j ˆ | a seria suficiente ´
para uma coleta de dados mais eficiente.
Ademais, a regressao linear utilizada n ˜ | ao contempla a ˜
física esperada e este pode ser efeito do baixo numero de ´ amostras ou pelas quedas de tensao ao longo do circuito de ˜ acionamento que impedem que de fato os 12 V cheguem
ao motor(tensao m ˜ | axima de operaç ´ | ao do motor). ˜
Entretanto, mesmo com os problemas aqui expostos foi possível controlar minimamente a velocidade do motor, caracteriza-lo e projetar um simples filtro. Desse ´ forma, produziu-se resultados relevantes a partir dessa metodologia pouco ortodoxa de controle de velocidade. A aplicaçao de t ˜ ecnicas de controle possibilitou polir ´ e controlar dados estaveis a partir de um sistema ruidoso, ´ o que foi um resultado de boa relevancia. ˆ
Pudemos praticar aplicaçao de t ˜ | ecnicas de controle ´
amplamente empregadas, e tambem praticar coleta de ´ dados.
V. REFERENCIAS ˆ
[1] M. S. Hons and R. R. Stewart. Transfer Functions of Geophones and Accelerometers and Their Effects on Frequency Content and Wavelets. CREWES Research Report — Volume 18, University of Calgary, 2006.
[2] ANALOG DEVICES. ADXL345: 3-Axis, ±2 g/±4 g/±8 g/±16 g Digital Accelerometer. Preliminary Techni-cal Data. Rev. PrA. Norwood, MA: Analog Devices, 2008. 24 p. Disponível em: http://www.analog.com. Acesso em: 14 de dez. de 2025.

[3] “DC Motor Speed: System Modeling,” Control Tutorials for MATLAB and Simulink, Univ. of Michigan, Carnegie Mellon Univ., Univ. of Detroit Mercy. [Online]. Disponível: ⟨https://ctms.engin.umich.edu/CTMS/index.php?example=MotorSpeed&section=SystemModeling⟩. Acesso em: 15/11/2025.
[4] Bruno A. Angelico and Gabriel P. Das Neves. ´ Controle Digital Aplicado. Editora Blucher, 2023.
[5] E. M. HEMERLY. Controle por Computador de Sistemas Dinamicos. Editora Blucher, 2nd edition, 2000. ˆ
[6] Katsuhiko Ogata. Discrete-Time Control Systems. Prentice Hall, 2nd edition, 1995.
[7] | FERNANDES, | Marcos | Rogerio. ´
Notas de aula - Controle Digital. | Sao | Carlos: ˜
Universidade de Sao Paulo, Escola de Engenharia ˜
de Sao Carlos, 2025. Dispon ˜ | ível em: ⟨https://edisciplinas
.usp.br/course/view.php?id=132285&section=0⟩. Acesso em: dez. 25.

VI. APENDICE ˆ

A. Valores de Identificaçao usando a tfest do matlab e ˜ 10ms de período de amostragem
Tabela II: Relatorio de Identificaç ´ | ao (Grid Search) ˜
Polos | Zeros | Fit (%) | Status
1 | 1 | 5.0560% | OK
1 | 2 | — | Ignorado (nz > np)
1 | 3 | — | Ignorado (nz > np)
1 | 4 | — | Ignorado (nz > np)
2 | 1 | 5.4341% | OK
2 | 2 | 9.4927% | OK (Melhor Fit)
2 | 3 | — | Ignorado (nz > np)
2 | 4 | — | Ignorado (nz > np)
3 | 1 | 6.3697% | OK
3 | 2 | 5.5454% | OK
3 | 3 | 8.9092% | OK
3 | 4 | — | Ignorado (nz > np)
4 | 1 | 6.2688% | OK
4 | 2 | 9.4505% | OK
4 | 3 | 8.6003% | OK
4 | 4 | 9.4738% | OK
Os codigos utilizados na pr ´ | atica est ´ | ao dispon ˜ | íveis em:
https://github.com/HandelNatividade/DCMotorControl -By-Acceleration. (https://github.com/HandelNatividade/DCMotorControl-By-Acceleration)
