HandelNatividade/DCMotorControl-By-Acceleration/(commit log)

2025-12-15 PRBS_Code_Matlab
    Matlab Code to implement with a Serial Connection with the arduino.
    This code will activate the "PRBS" function described in the .ino code and its graphic may be obtained loading the code "load_prbs.m".
2025-12-15 Simple FT
    Function to obtain the Transfer Function with no filter.
2025-12-15 .ino code
    This codes adds some important functions in our system besides using SPI communication with the accelerometer.
    It has the function "stop", to stop the system, "1/0" to use the PID, "prbs" to get te prbs results, "medir,0" give a computer radable log (for matlab) while "medir,1" produces a human readable log, "calib1" is the function to promote the x,y, and z offset.
    You also can control the setpoint and the pwm via serial.
